abhishekdahal4/Three-Band-Active-Audio-Equalizer/Three_Band_Active_Audio_Equalizer_Design_Report.pdf

## THREE-BAND ACTIVE AUDIO EQUALIZER

This report documents the intended analog filter behavior of a three-band audio equalizer using LM741 operational amplifiers. It consolidates the separate low-pass, band-pass, and high-pass calculations and uses component values from the supplied combined KiCad schematic. All numerical response values below are theoretical calculations, not measured laboratory results.

### 1. System overview

The signal is buffered, split into three frequency-selective paths, independently attenuated by potentiometers, and recombined by an output summing stage. A fourth potentiometer controls the final output level. The supplied schematic labels the op-amp supplies as +15 V and −15 V.

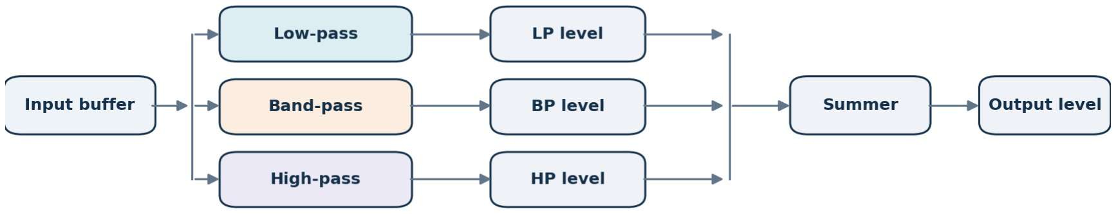
[picture p1: figure]

Signal architecture of the intended three-band active equalizer.

Stage | Schematic components | Frequency characteristic / role
Low-pass (LP) | R1 = 22 kΩ; R2 = 22 kΩ; C1 = 22 nF | Single-pole cutoff: 329 Hz
Band-pass (BP) | R5 = 15 kΩ; C3 = 22 nF; R6 = 15 kΩ; C4 = 6.8 nF | RC corners: 482 Hz, 1.56 kHz; peak near 867 Hz
High-pass (HP) | R3 = 2.2 kΩ; C2 = 33 nF; R4 = 2.2 kΩ | Single-pole cutoff: 2.19 kHz
Mixing and output | POT1–POT4, R7–R12, LM741 summer | Independent level setting and recombination

Theoretical individual-stage frequency response

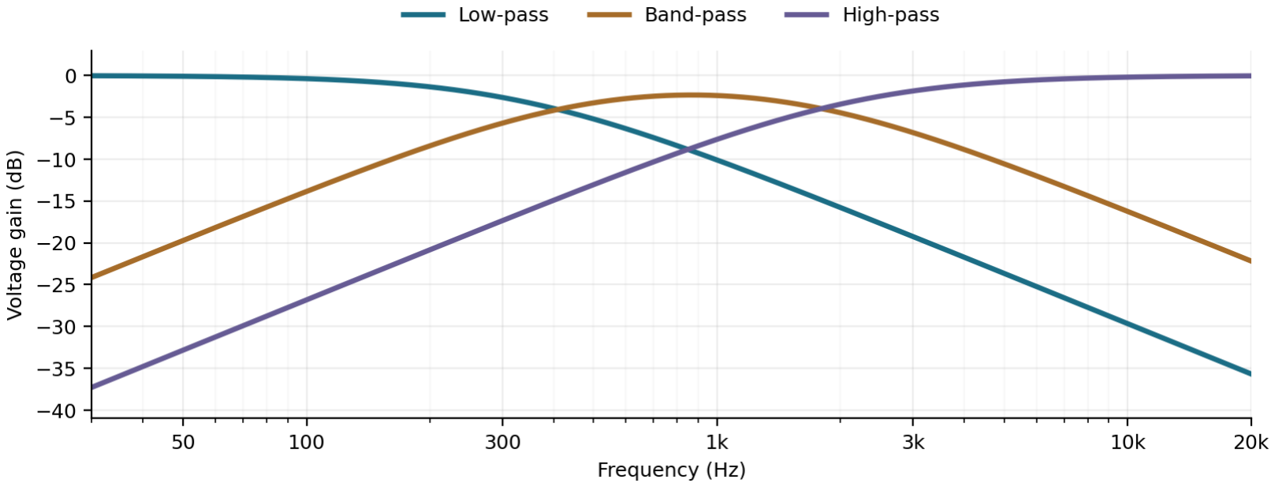
[picture p2: figure]

### 2. Low-pass filter

Purpose. Preserve lower-frequency audio while attenuating frequencies above the cutoff. The individual calculation uses an inverting op-amp with a resistor at the input and a parallel resistor–capacitor feedback network.

Impedance and transfer-function derivation

Taking s = jω, and using ZC = 1/(sC), the input and feedback impedances are:

Zin = R1

Zf = R2 ∥

1
sC1

=

R2
1 + sR2C1

For the intended inverting topology with ideal negative feedback, H(s) = −Zf/Zin:

HLP(s) = −

R2/R1
1 + sR2C1

The magnitude decreases as frequency increases:

|HLP(jω)| =

R2/R1
√1 + (ωR2C1
)

2

Component selection and cutoff frequency

Component | Chosen value | Function
R1 | 22 kΩ | Input resistance
R2 | 22 kΩ | Feedback resistance; sets DC gain and cutoff
C1 | 0.022 µF = 22 nF | Feedback capacitance
The DC gain is −R2/R1 = −1 V/V (magnitude 1 V/V, or 0 dB). At the −3 dB cutoff:

fc,LP =

1
2πR2C1

fc,LP =

1
2π(22 × 10³)(22 × 10⁻⁹)

= 328.83 Hz

The original low-pass calculation targeted approximately 320 Hz, with a 22 kΩ standard resistor and 22 nF capacitor. These chosen parts produce a nominal cutoff of 329 Hz, close to that target.

Expected behavior

At low frequency, HLP → −1; at the cutoff, the magnitude is 1/√2 ≈ 0.707 V/V; and far above the cutoff the magnitude falls at approximately 20 dB/decade. The negative sign indicates a nominal 180° signal inversion within the passband.

### 3. Band-pass filter

Purpose. Emphasize a middle-frequency band by combining a capacitive high-pass input path with a capacitive low-pass feedback path around an inverting op-amp. The separate band-pass notes derive the same topology shown in the component list below.

Impedance and transfer-function derivation

The series input branch consists of R5 and C3

. The feedback branch consists of R6

in parallel with C4
:

Zin = R5 +

1
sC3

=

1 + sR5C3
sC3

Zf = R6 ∥

1
sC4

=

R6
1 + sR6C4

The ideal inverting transfer function is therefore:

HBP(s) = −

sR6C3
(1 + sR5C3

)(1 + sR6C4

)

At very low frequency, the series input capacitor blocks the signal. At very high frequency, the feedback capacitor reduces the feedback impedance. The combination passes a middle range.

Selected parts and characteristic frequencies

Component | Value | Function
R5 | 15 kΩ | Series input resistor
C3 | 0.022 µF = 22 nF | Series input capacitor
R6 | 15 kΩ | Feedback resistor
C4 | 6.8 nF | Feedback capacitor

The two individual RC corner frequencies in the transfer-function denominator are:

flow,RC =

1
2πR5C3

=

1
2π(15 × 10³)(22 × 10⁻⁹)

= 482.29 Hz

fhigh,RC =

1
2πR6C4

=

1
2π(15 × 10³)(6.8 × 10⁻⁹)

= 1560.34 Hz

The peak-response frequency for this ideal first-order high-pass / low-pass combination is the geometric mean:

fpeak = √flow,RCfhigh,RC = 867.49 Hz

Its theoretical peak magnitude is:

|HBP|peak =

R6C3
R5C3 + R6C4

= 0.764 V/V

Interpretation. The 482 Hz and 1.56 kHz values describe separate RC corners; they are not the −3 dB limits of the combined band-pass response. The composite response has approximately 319 Hz and 2.36 kHz half-power frequencies relative to its peak, owing to the overlap of the two gradual slopes.

### 4. High-pass filter

Purpose. Attenuate low frequencies while retaining higher-frequency content. In the original high-pass notes, a series resistor– capacitor input drives an inverting stage with resistive feedback.

Transfer function and component selection

For the integrated design, the input branch is R3 and C2

in series, while the feedback branch is R4 :

Zin = R3 +

1
sC2

=

1 + sR3C2
sC2

, Zf = R4

HHP(s) = −

sR4C2
1 + sR3C2

The high-frequency passband gain approaches −R4/R3 = −1 V/V. The cutoff frequency is:

fc,HP =

1
2πR3C2

fc,HP =

1
2π(2.2 × 10³)(33 × 10⁻⁹)

= 2192.22 Hz

Component | Value | Function
R3 | 2.2 kΩ | Series input resistor
C2 | 0.033 µF = 33 nF | Series input capacitor
R4 | 2.2 kΩ | Feedback resistor

Below 2.19 kHz, the magnitude decreases toward zero as the signal frequency falls. Above the cutoff, it approaches unity (0 dB). This is a nominal first-order filter with approximately 20 dB/decade low-frequency rise.

### 5. Level controls and summing stage

Each filter output feeds a potentiometer (POT1, POT2, and POT3). The potentiometer wipers pass through their respective input resistors to a common op-amp summer. For a correctly wired inverting summing amplifier, the ideal relationship would be:

VSUM = −R12 (

αLPVLP
R7

+

αHPVHP
R8 + R9

+

αBPVBP
R10 + R11

)

Here α denotes each control’s ideal unloaded wiper fraction (0–1); actual gain also depends on loading. With the shown resistor values, the nominal contribution magnitudes are 1.00× (LP: 10 kΩ), 1.22× (HP: 8.2 kΩ), and 0.91× (BP: 11 kΩ) before wiper attenuation. R12 is 10 kΩ. POT4 acts as the final output level control; its value and the load value are not specified in the supplied drawing.

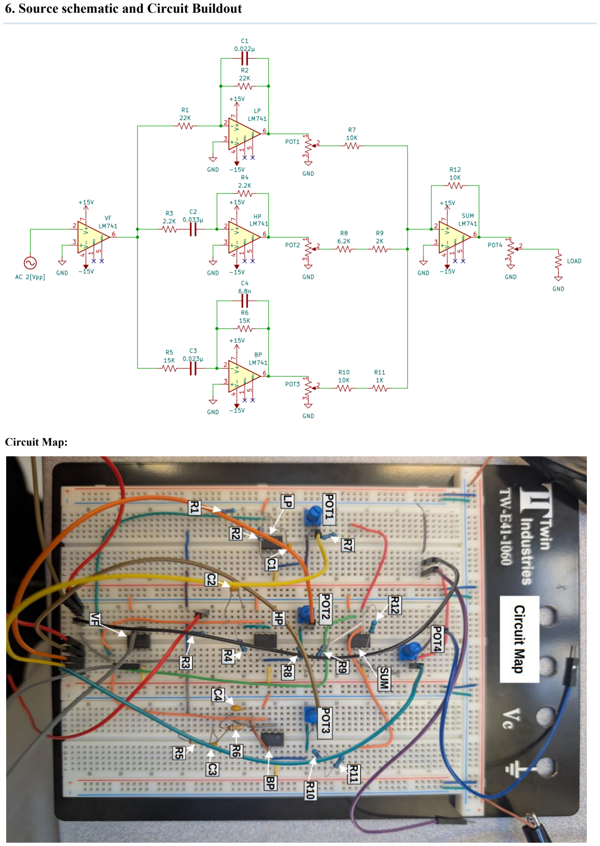
[picture p3: page 5]

### 6. Source schematic and Circuit Buildout

Circuit Map:

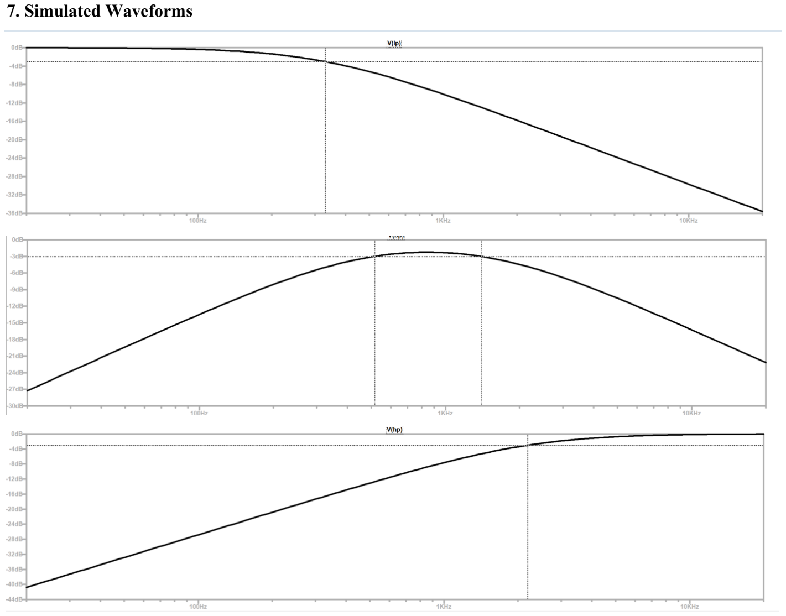
[picture p4: page 6]

### 7. Simulated Waveforms
