abhishekdahal4/Three-Band-Active-Audio-Equalizer/3bandEQ.asc

BP: LM741
C1: cap; 0.022µ
C2: cap; 0.033µ
C3: cap; 0.023µ
C4: cap; 6.8n
HP: LM741
LP: LM741
POT1: res; 10k
POT2: res; 10k
POT3: res; 0
R1: res; 22k
R2: res; 22k
R3: res; 2.2k
R4: res; 2.2k
R5: res; 15k
R6: res; 15k
R7: res; 10k
R8: res; 6.2k
R9: res; 2k
R10: res; 10k
R11: res; 1k
R12: res; 10k
R14: res; 0
SUM: LM741
V1: voltage; -15
V2: voltage; 15
V3: voltage; ""; AC 1
V4: voltage; -15
V5: voltage; 15
V6: voltage; -15
V7: voltage; 15
V8: voltage; -15
V9: voltage; 15
V10: voltage; 15
V11: voltage; -15
VF: LM741
Named nets: 0, BP, HP, LP
.ac dec 100 20 20k
High Pass
Low Pass
Band Pass
10k POT
10k POT
10k POT
10k POT
2[V] pp
2[V] Offset
